asmnoak/DSP_Radio_RDA5807_with_recording_to_SD_of_XIAO_ESP32S3_SENSE/xiao_esp32s3_sense_rda5807_pcm5102_sd_sch.pdf

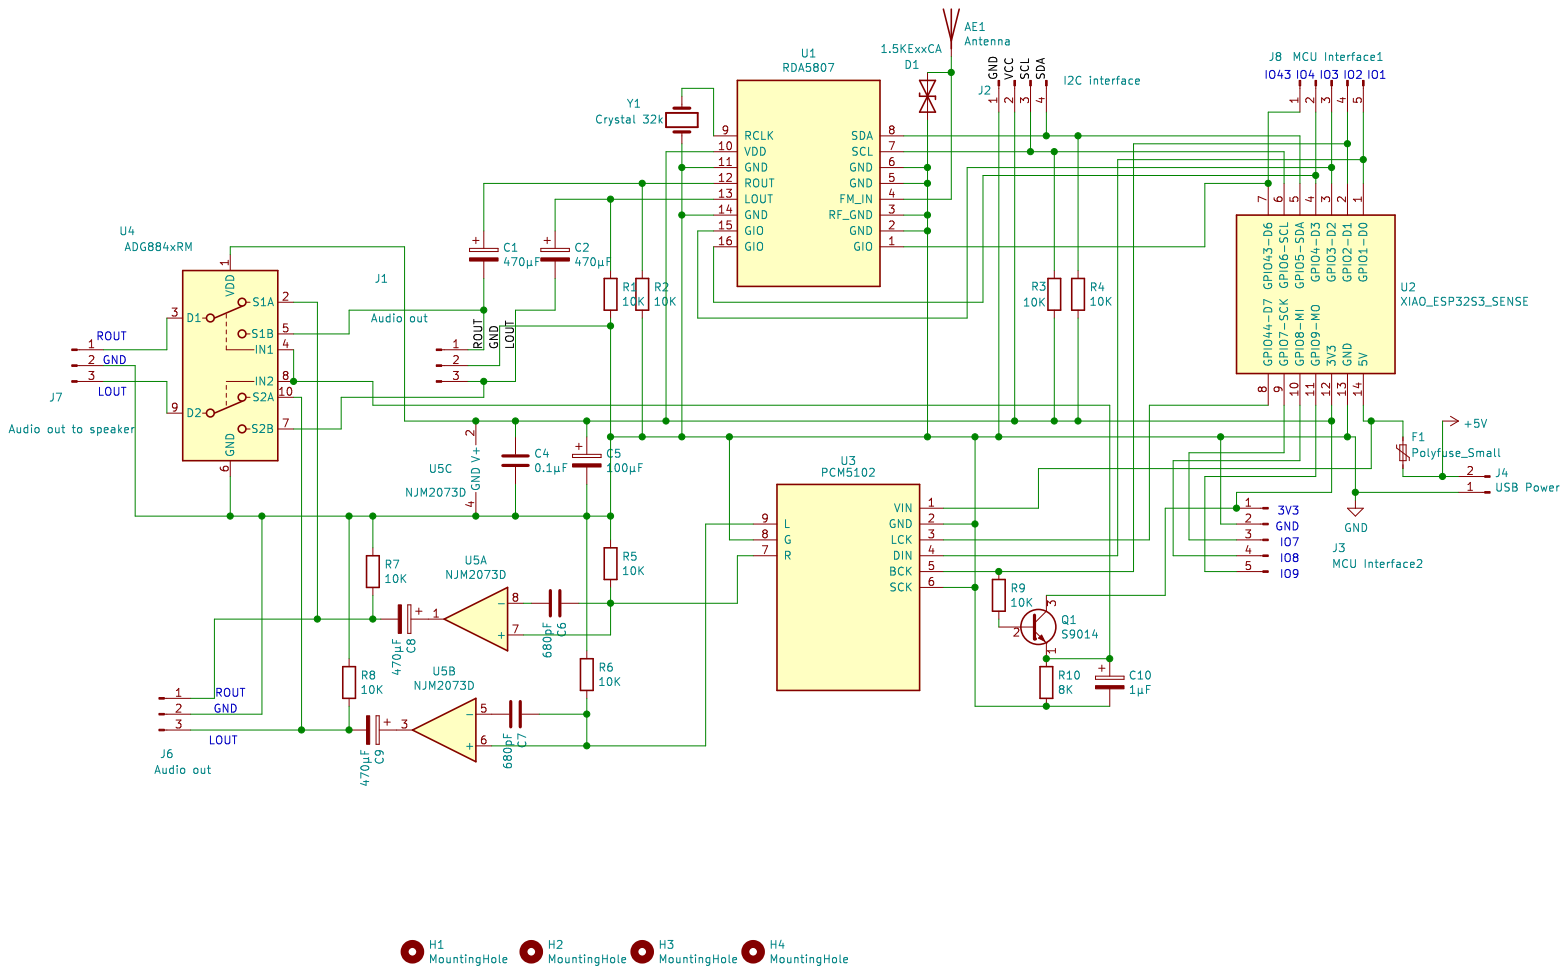
[picture p7: page 1]
